desiFish/Water-Pump-Controller-V2/(threads)

Thread 3 (2024-10-31):

Time to fill

KamadoTanjiro-beep, 2024-10-31:
Based on ultrasonic sensor data, predict time to fillup the water tank

KamadoTanjiro-beep, 2024-11-25:
Not Implementing This. Reasons:
1. The sensor readings fluctuates a lot when water is falling from a height.
2. More stable sensor is needed, these sensor have a range of 25-450 cm, hence less than 25cm readings are not accurate.
3. It might still be possible to do this, it is easy actually but it is not worth it as the time will lack accuracy to a large degree.

Closed 2024-11-25.

Thread 4 (2024-10-31):

Integrate the Current Sensor

KamadoTanjiro-beep, 2024-10-31:
Except Current sensor, everything else have been integrated. The project can't monitor current and wattage without this... hence no dry run protection. Although automatic cut-off of pump at tank full will still work.

Closed 2024-11-01.

Thread 8 (2024-11-01):

Calculation error

KamadoTanjiro-beep, 2024-11-01:
Current updation is happening faster than voltage updation, hence, wattage calculation that is being shown on the screen may often differ than the actual tat any given moment.

KamadoTanjiro-beep, 2024-11-27:
WIll be opened once voltage sensor works

Closed 2024-11-27.

Thread 10 (2024-11-03):

Water Wastage Monitoring

desiFish, 2024-11-03:
This project might help in saving water. How?
During inactive hours, it can be set to monitor water levels in tank using ultrasonic or any other distance tracking sensors and warn the user of potential water wastage through leakage or running tap.

Closed 2025-02-06.

Thread 11 (2024-11-06):

Voltage Sensor Calibration

KamadoTanjiro-beep, 2024-11-06:
- During final integration and testing, voltage sensor gave higher values, tried to fix it but couldn't. I will look into it later. Right now it works flawlessly, will test it everyday and update if any bug occurs.
- Need help, if anyone from India can fix the calibration issue, please let me know.

KamadoTanjiro-beep, 2024-11-27:
The voltage sensor is disabled for the time being due to a calibration issue. Please use separate voltage protection for the time being.

desiFish, 2025-02-05:
It was working well during unit testing

Thread 12 (2024-11-21):

Relay Issue

KamadoTanjiro-beep, 2024-11-21:
Fotek 40A SSR suddenly fails to run the 1HP water pump. Sometimes, it runs, and sometimes, it doesn't. When it doesn't, it makes a loud rumbling noise.
I read at StackExchange that, capacitor pumps and SSRs are NOT to be paired together in the long run.

I changed the really with 100A SSR. If this also fails I will go for the 30A Mechanical relay

I will let you know about this situation.

desiFish, 2025-01-12:
100A SSR Seems to be working fine. I will update again after a few months.

desiFish, 2025-02-06:
100A SSR from Frtoke is still running great.

Thread 13 (2025-01-12):

Current calibration as menu option

desiFish, 2025-01-12:
Add current calibration as a menu option

desiFish, 2025-02-06:
`This calibration should be done, while the pump is running and parallel monitoring the same in the household energy meter with no other load. Hence, setting the exact ampere being drawn.`

Thread 14 (2025-02-03):

Ultrasonic Serial Read Issue

desiFish, 2025-02-03:
When ultrasonic is not connected, but turned on in settings, the ESP32 restarts in loop. The primary issue is that the Serial Monitor for ultrasonic returns garbage values even when nothing is connected and ESP32 tries to make sense of it and fails. The secondary issue is that it is running on CORE 0 and hence there is some kind of issue that is not faced by CORE 1 a.k.a. loop(). I'll check it in detail later.

Thread 15 (2025-02-06):

Ideas

desiFish, 2025-02-06:
1. Separate completion tone for normal 100% fillup, User Interrupt or error stop.
2. for less than 1 minute pump run there will be no logging.
