desiFish/Water-Pump-Controller-V2/resource/SCH_Schematic1.pdf

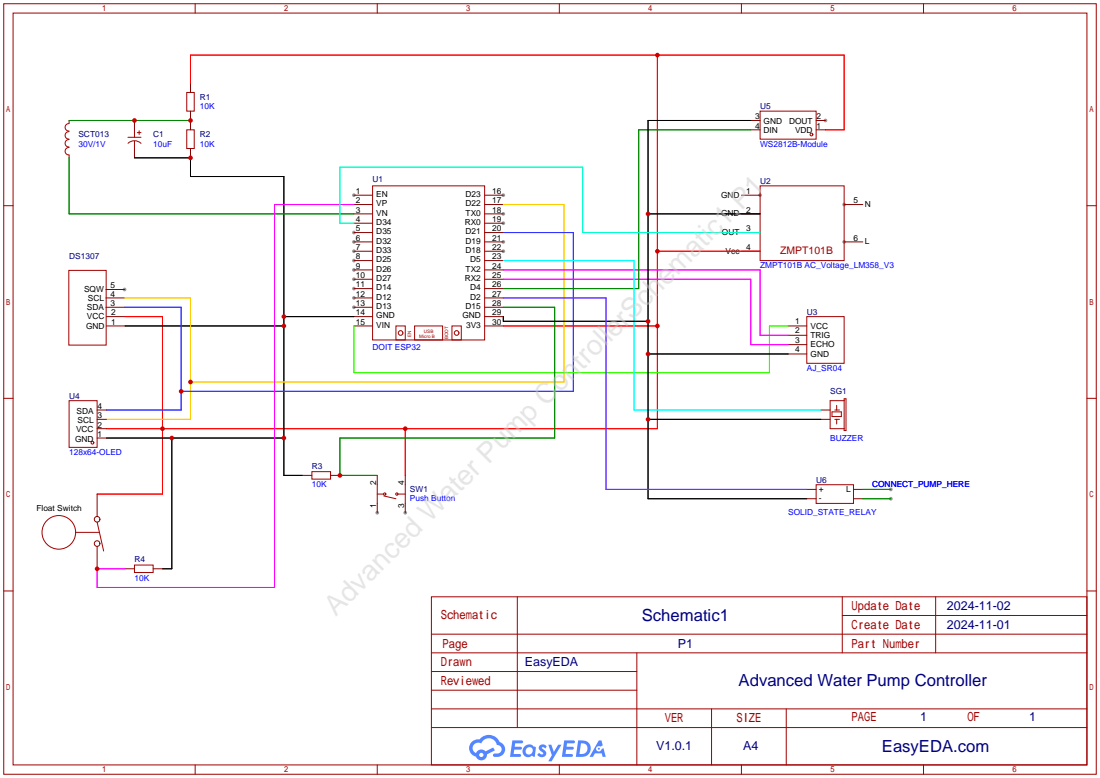
[picture p14: page 1]
