desiFish/Water-Pump-Controller-V2/(commit log)

2024-11-01 V1.0.1-alpha
    *Integrated the current sensor (calibrate it according to your need)
    *Added Pump Turn On Delay (for waiting so that current and voltage values stabilises or pump primes itself)
    *Added Float sensor Raw value reading under Diagnostics in Menu.
    * Minor other changes.
2024-11-02 Corrected Schematics
2024-11-06 1.0.3-alpha
    - Removed diagnostics and combined it with Syswatcher function.
    - Optimised other areas (some of them related to removing voltage sensor functions)
2024-11-22 Update Advanced-Water-Pump-Controller.ino
    * removed "voltage" component as of now.
    * wifi can now be turned off from settings
    * code optimization
    * other misc. updates
2024-11-27 V1.1.2-beta
    * addition of timer or time taken to fill
    * time update at startup (if wifi is connected)
    * further tweaks and improvements
2025-01-12 docs: enhance README with improved formatting and clarity for logging methods and sensor calibration
2025-03-26 refactor: update wait time after pump activation and improve volume display logic
2025-03-26 refactor: average current every 30 seconds in loop2 function
2026-06-17 add link to Pictures & Schematics in Table of Contents
2026-09-23 update table of contents with additional sections for tank calibration, current limits, and more
